DefinitiveDiagnosisDev/PredictiveMaintenance/README.md

# CAN-based monitoring and Predictive maintenance system


I’m starting a step-by-step engineering series where I design a CAN monitoring and predictive maintenance system from scratch - slowly, transparently, and using real systems engineering practices.
This is a learning journey for me but I look forward to learning from your comments also. Off we go down another rabbit hole !!!!!
I have chosen the New Arduino Uno Q for this project.

Step 1: Project overview.

Step 2: System requirements.

Step 3: Architecture design.

Step 4: Implementation, validation & insights.

This isn’t a “here’s some code” project.

It covers:

CAN fundamentals

Embedded + Linux architectures

Real-time vs non-real-time design

DBC-based signal decoding

Data logging & basic predictive maintenance algorithms

Clear documentation at every stage

I’ll be sharing hardware photos/videos, architecture diagrams, and short PDFs explaining why each decision is made , not just what works.


The PLAN (Lets see how far we can get in 2026 !!) :

🟦 Phase 0 – Systems Engineering 

📄 PDF 0.1 – Project overview & goals

📄 PDF 0.2 – Functional & non-functional requirements

📄 PDF 0.3 – System context diagram

📄 PDF 0.4 – High-level architecture (MCU vs Linux split)

🟦 Phase 1 – Hardware Architecture

📄 PDF 1.1 – Arduino UNO Q architecture explained

📄 PDF 1.2 – Why MCP2515? Design trade-offs

📄 PDF 1.3 – Hardware block diagram

📄 PDF 1.4 – Wiring & power considerations

🟦 Phase 2 – CAN Fundamentals & Validation

📄 PDF 2.1 – CAN fundamentals (IDs, DLC, frames)

📄 PDF 2.2 – CAN transmit setup

📄 PDF 2.3 – Test frames & validation strategy

🟦 Phase 3 – MCU Software Architecture

📄 PDF 3.1 – MCU responsibilities & task design

📄 PDF 3.2 – MCP2515 driver overview

📄 PDF 3.3 – CAN receive loop & buffering

📄 PDF 3.4 – Timing & data integrity

🟦 Phase 4 – Inter-Processor Communication

📄 PDF 4.1 – What is Arduino Bridge (RPC)?

📄 PDF 4.2 – Message formats & contracts

📄 PDF 4.3 – Data flow MCU → Linux

🟦 Phase 5 – Linux Software Architecture

📄 PDF 5.1 – Python application structure

📄 PDF 5.2 – DBC decoding

📄 PDF 5.3 – Validation 

🟦 Phase 6 – Data Storage & Replay

📄 PDF 6.1 – Why MF4?

📄 PDF 6.2 – Writing MF4 files

📄 PDF 6.3 – Data replay & verification

🟦 Phase 7 – Predictive Maintenance Logic

📄 PDF 7.1 – What is predictive maintenance?

📄 PDF 7.2 – Rule-based detection

📄 PDF 7.3 – Statistical anomaly detection

📄 PDF 7.4 – Edge vs off-board trade-offs

🟦 Phase 8 – Event Handling & Alerts

📄 PDF 8.1 – Event definition & states

📄 PDF 8.2 – Email alert design

📄 PDF 8.3 – End-to-end system test
