DefinitiveDiagnosisDev/PredictiveMaintenance/Phase 8 - Event Handling & Alerts/G_Sheet_Output.jpg

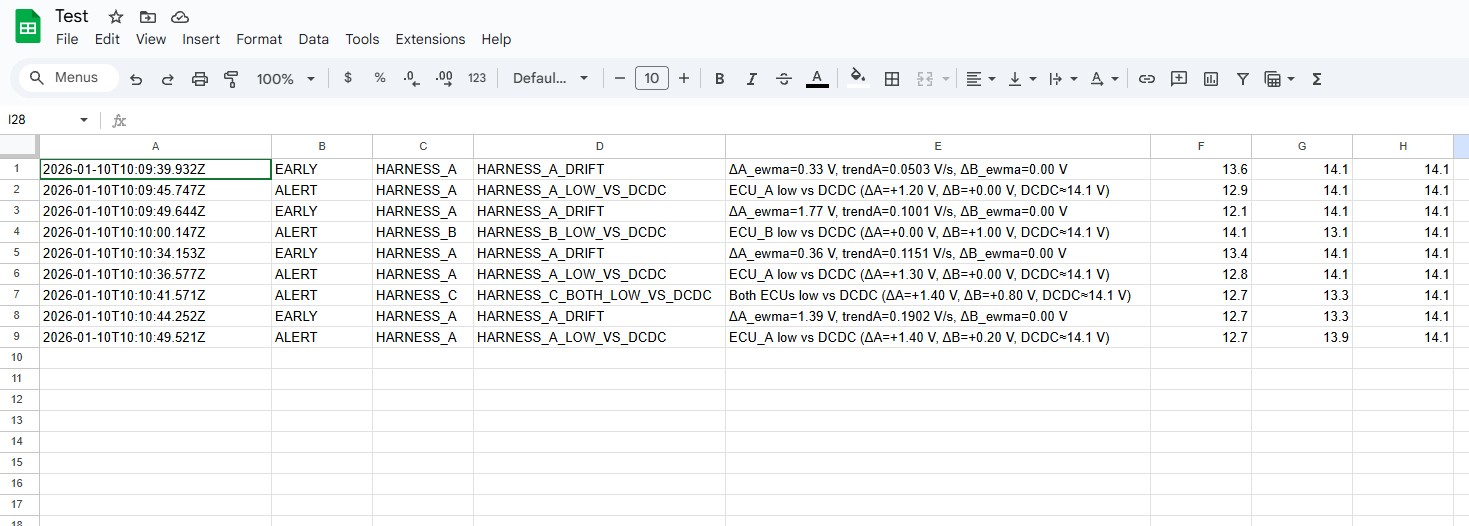
Phase 8 - Event Handling & Alerts/G_Sheet_Output.jpg
