DefinitiveDiagnosisDev/PredictiveMaintenance/Phase 6 - Data Storage & Replay/Predictive_Live_Log_Results.txt

ts_iso = datetime.utcnow().isoformat(timespec="milliseconds") + "Z"
[STATS] frames_seen=3 decoded=3 ECU_A=14.10 V ECU_B=14.10 V DCDC=14.10 V
[STATS] frames_seen=6 decoded=6 ECU_A=14.10 V ECU_B=14.10 V DCDC=14.10 V
[STATS] frames_seen=9 decoded=9 ECU_A=14.10 V ECU_B=14.10 V DCDC=14.10 V
[STATS] frames_seen=12 decoded=12 ECU_A=14.10 V ECU_B=14.10 V DCDC=14.10 V
[STATS] frames_seen=15 decoded=15 ECU_A=14.10 V ECU_B=14.10 V DCDC=14.10 V
[STATS] frames_seen=18 decoded=18 ECU_A=14.00 V ECU_B=14.10 V DCDC=14.10 V
[STATS] frames_seen=21 decoded=21 ECU_A=13.60 V ECU_B=14.10 V DCDC=14.10 V
[ALERT][HARNESS_A] ECU_A=13.30 V ECU_B=14.10 V DCDC=14.10 V | ECU_A low vs DCDC (ΔA=+0.80 V, ΔB=+0.00 V, DCDC≈14.1 V)
[STATS] frames_seen=24 decoded=24 ECU_A=13.30 V ECU_B=14.10 V DCDC=14.10 V
[ALERT][HARNESS_A] ECU_A=13.10 V ECU_B=14.10 V DCDC=14.10 V | ECU_A low vs DCDC (ΔA=+1.00 V, ΔB=+0.00 V, DCDC≈14.1 V)
[STATS] frames_seen=27 decoded=27 ECU_A=13.10 V ECU_B=14.10 V DCDC=14.10 V
[STATS] frames_seen=30 decoded=30 ECU_A=13.40 V ECU_B=14.10 V DCDC=14.10 V
[STATS] frames_seen=33 decoded=33 ECU_A=13.80 V ECU_B=14.10 V DCDC=14.10 V
[STATS] frames_seen=36 decoded=36 ECU_A=14.00 V ECU_B=14.10 V DCDC=14.10 V
[STATS] frames_seen=39 decoded=39 ECU_A=14.10 V ECU_B=14.10 V DCDC=14.10 V
[STATS] frames_seen=42 decoded=42 ECU_A=14.10 V ECU_B=14.10 V DCDC=14.10 V
[STATS] frames_seen=45 decoded=45 ECU_A=14.10 V ECU_B=14.10 V DCDC=14.10 V
[STATS] frames_seen=48 decoded=48 ECU_A=14.10 V ECU_B=13.70 V DCDC=14.10 V
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
[ALERT][HARNESS_C] ECU_A=13.20 V ECU_B=13.10 V DCDC=14.10 V | Both ECUs low vs DCDC (ΔA=+0.90 V, ΔB=+1.00 V, DCDC≈14.1 V)
[STATS] frames_seen=135 decoded=135 ECU_A=13.20 V ECU_B=13.10 V DCDC=14.10 V
[STATS] frames_seen=138 decoded=138 ECU_A=13.20 V ECU_B=13.10 V DCDC=14.10 V
[ALERT][HARNESS_C] ECU_A=13.20 V ECU_B=13.10 V DCDC=14.10 V | Both ECUs low vs DCDC (ΔA=+0.90 V, ΔB=+1.00 V, DCDC≈14.1 V)
[STATS] frames_seen=141 decoded=141 ECU_A=13.20 V ECU_B=13.10 V DCDC=14.10 V
[ALERT][HARNESS_C] ECU_A=13.20 V ECU_B=13.10 V DCDC=14.10 V | Both ECUs low vs DCDC (ΔA=+0.90 V, ΔB=+1.00 V, DCDC≈14.1 V)
[STATS] frames_seen=144 decoded=144 ECU_A=13.20 V ECU_B=13.10 V DCDC=14.10 V
[ALERT][HARNESS_C] ECU_A=13.20 V ECU_B=13.10 V DCDC=14.10 V | Both ECUs low vs DCDC (ΔA=+0.90 V, ΔB=+1.00 V, DCDC≈14.1 V)
[STATS] frames_seen=147 decoded=147 ECU_A=13.20 V ECU_B=13.10 V DCDC=14.10 V
[ALERT][HARNESS_C] ECU_A=13.20 V ECU_B=13.10 V DCDC=14.10 V | Both ECUs low vs DCDC (ΔA=+0.90 V, ΔB=+1.00 V, DCDC≈14.1 V)
[STATS] frames_seen=150 decoded=150 ECU_A=13.20 V ECU_B=13.10 V DCDC=14.10 V
[ALERT][HARNESS_C] ECU_A=13.20 V ECU_B=13.10 V DCDC=14.10 V | Both ECUs low vs DCDC (ΔA=+0.90 V, ΔB=+1.00 V, DCDC≈14.1 V)
[STATS] frames_seen=153 decoded=153 ECU_A=13.20 V ECU_B=13.10 V DCDC=14.10 V
